SuperFabius/Z80-MBC/A041116 schematic.pdf

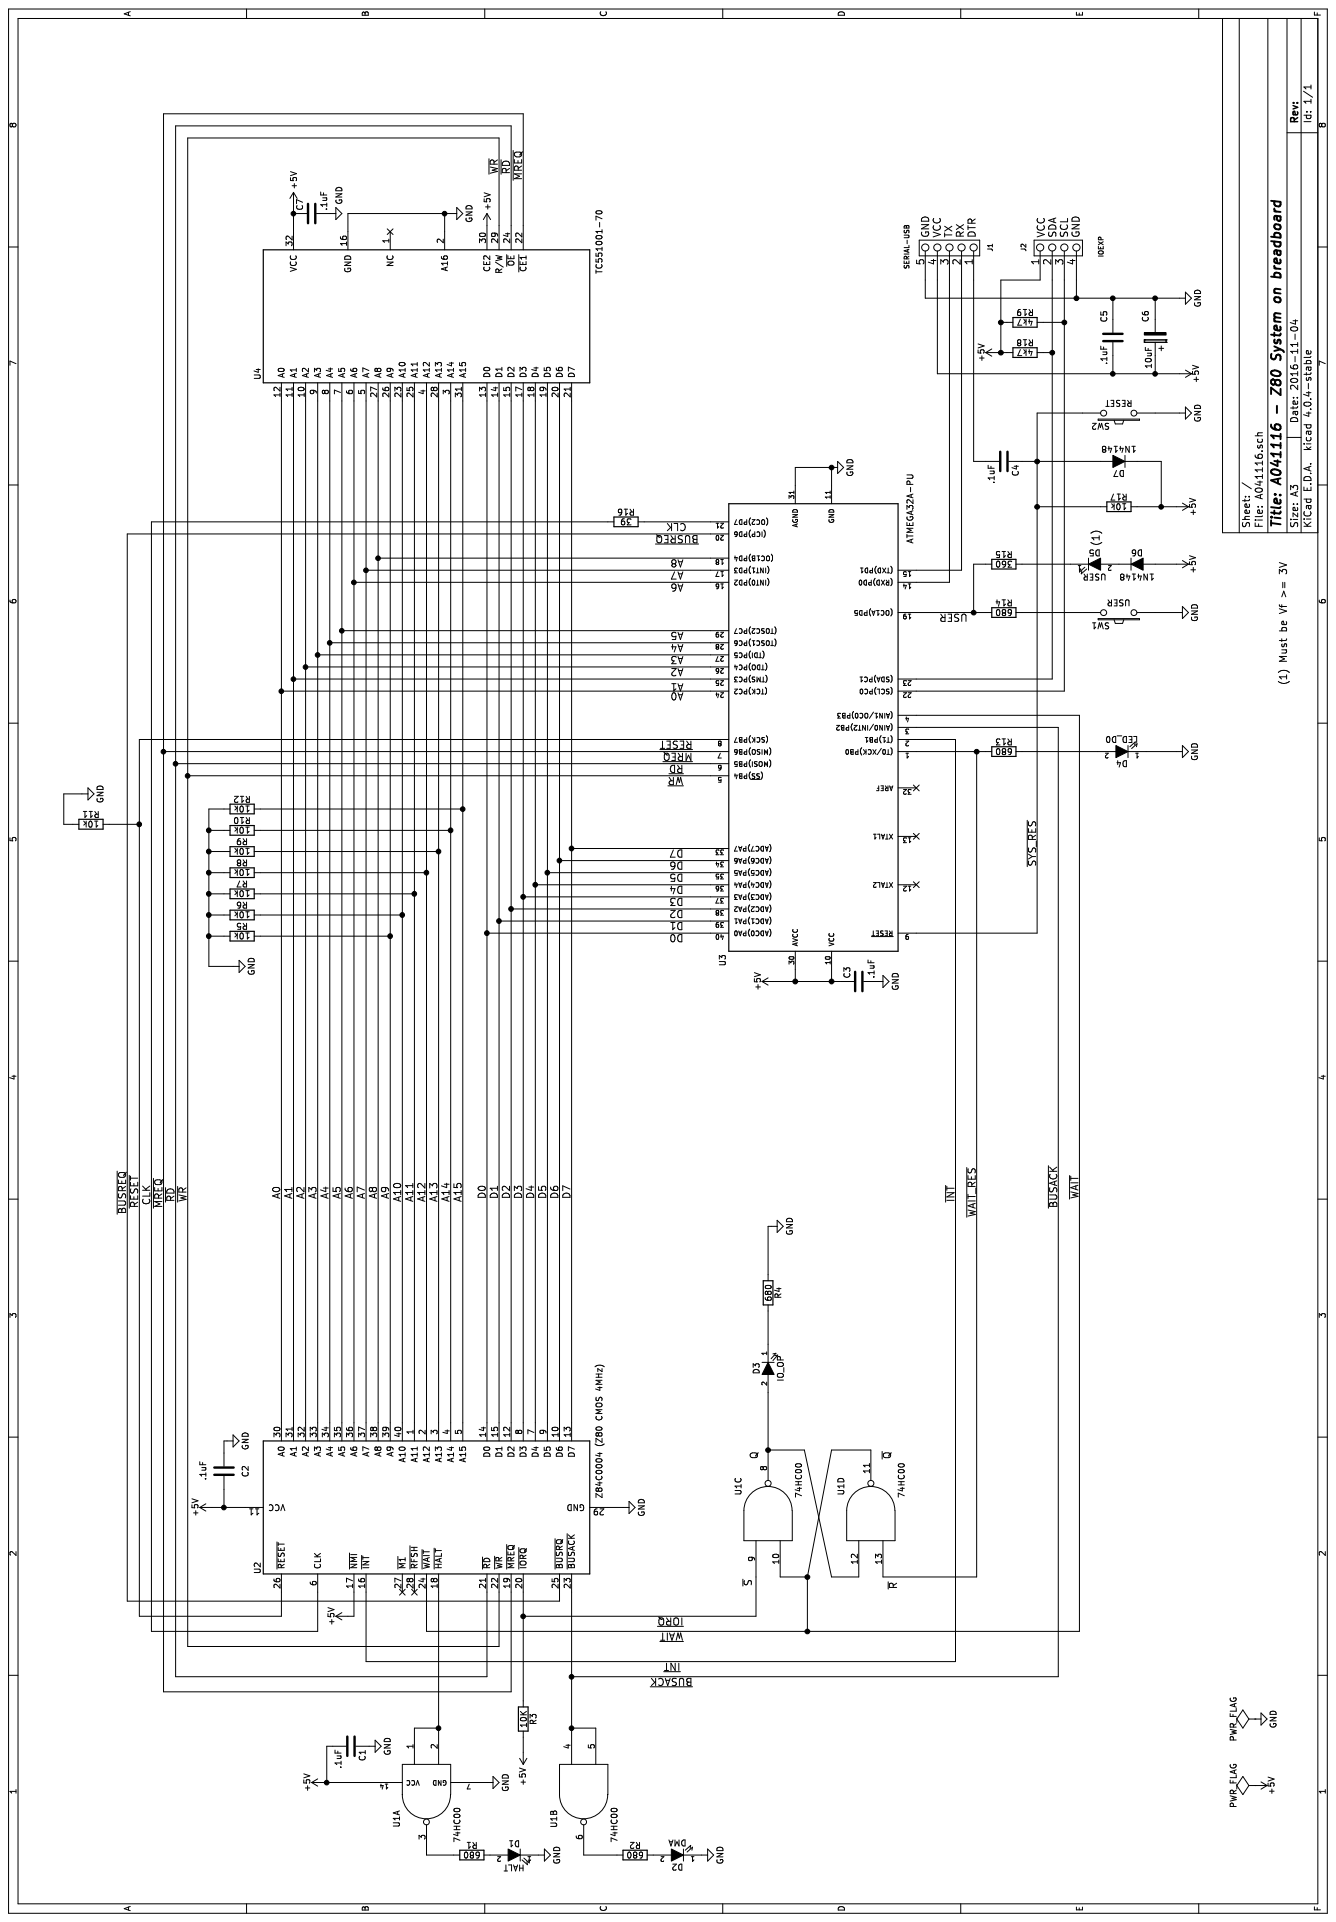
[picture p1: page 1]
