SuperFabius/Z80-MBC/A080117.pdf

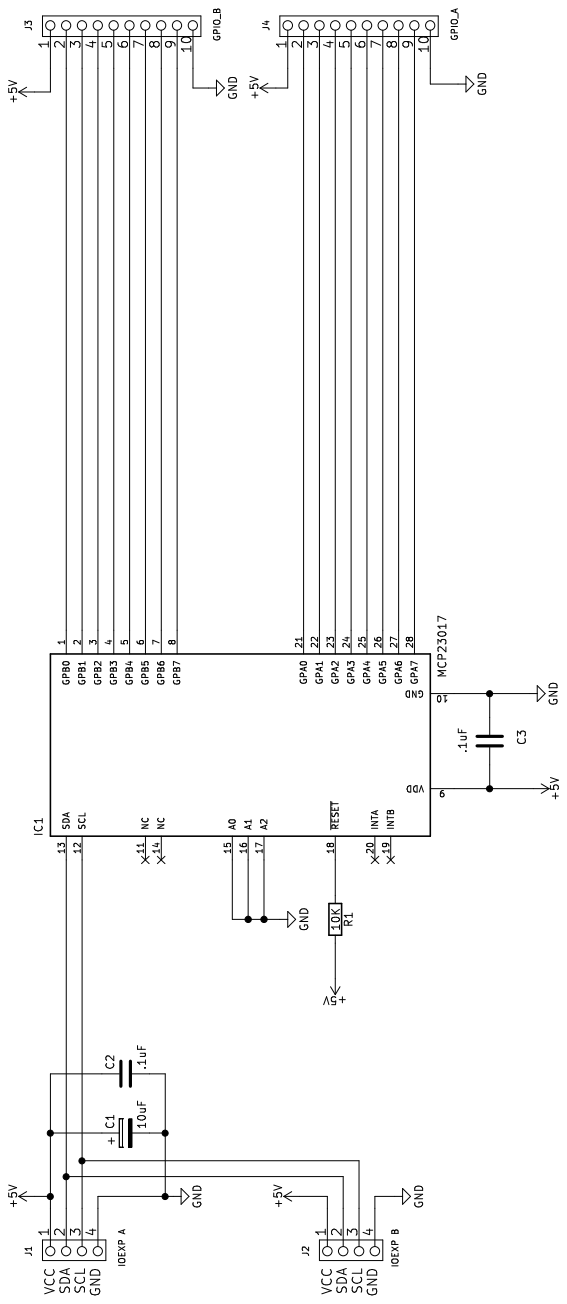
[picture p2: page 1]
