SuperFabius/Z80-MBC/A110417.pdf

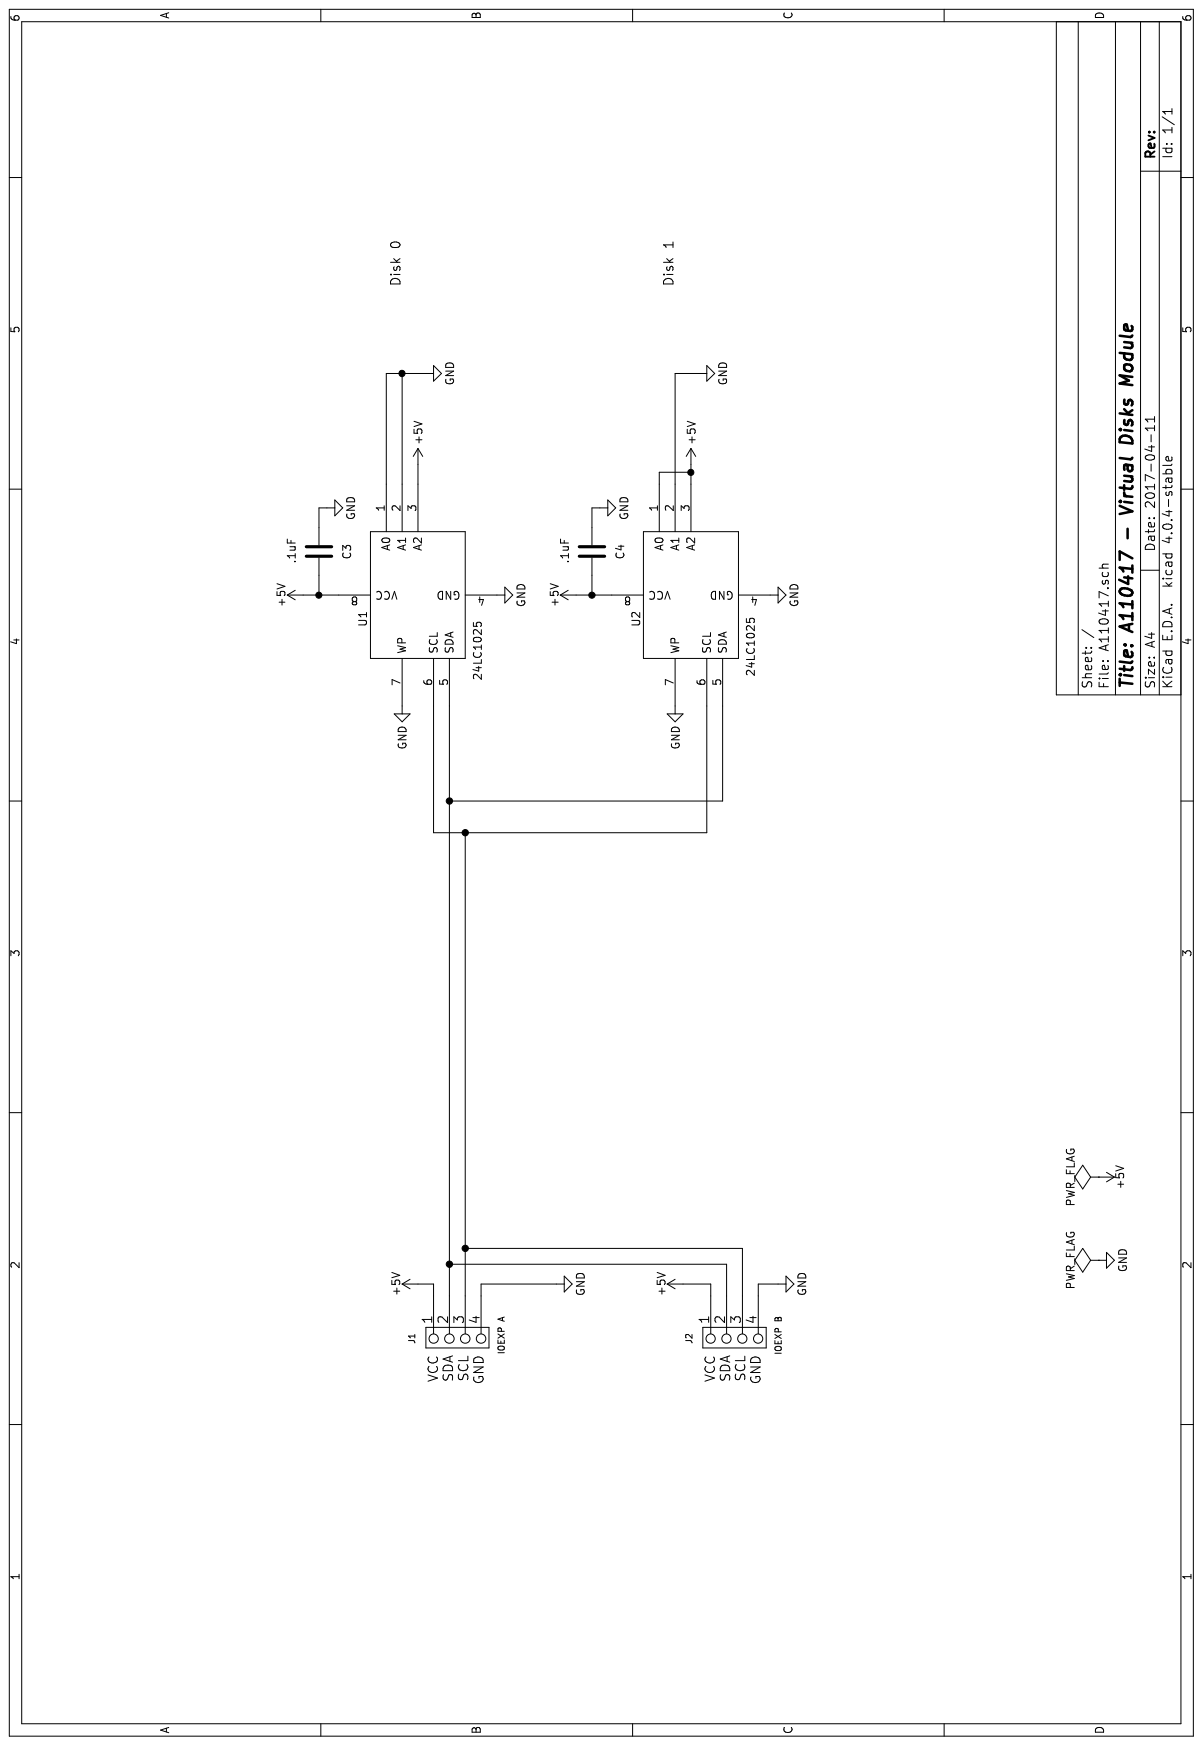
[picture p3: page 1]
