SuperFabius/Z80-MBC/S221116_R100218_Z80.ino

/* ------------------------------------------------------------------------------

S221116 R100218 - HW ref: A041116

IOS - I/O Subsystem - for Z80-MBC (Multi Boot Computer)
(Z80 64kB RAM @ 4Mhz)



Notes:

1:  This SW is ONLY for the Atmega32A used as EEPROM and I/O subsystem (8MHz internal oscillator).
    
2:  Tested on Atmega32A @ Arduino IDE 1.6.5.

3:  Embedded FW: S091216 R230117 uLoader, S121216 uBIOS + Basic, S260117 iLoad (Intel-Hex loader),
                 Forth interpreter, S150417 CP/M 2.2 Cold Loader

4:  Utilities:   S111216 TASM conversion utility

5:  Optional HW: A080117 (GPIO Expansion Module)
                 A110417 (Virtual Disk Module)
                 Generic DS3231 RTC

--------------------------------------------------------------------------------- */

/* ------------------------------------------------------------------------------

CHANGELOG:


S221116           First release.
S221116 R200117   Added support for the GPIO Extension Module (HW ref: A080117).
S221116 R230117   Added iLoad boot mode (S260117), updated uLoader (S091216 R230117).
S221116 R120217   Added Forth interpreter (porting made by Bill Westfield, see GitHub:
                  https://github.com/WestfW/4chipZ80/tree/master/Firmware/figForth )
                  and multi boot selection. Renamed from now as "Multi Boot Computer".
                  From this release the use of an Atmega32A is mandatory.
S221116 R180217   Added support for the Virtual Disk Module (HW ref: A110417).
S221116 R130417   Added CP/M Cold Loader (S150417) to support CP/M 2.2 and BIOS (S050217).
                  Single disk configuration now allowed (HW ref: A110417).
S221116 R300417   Added AUTOEXEC.SUB support for CP/M 2.2. Required new BIOS (S050217 R300417).
S221116 R110517   Added support for a generic DS3231 RTC for QP/M 2.71 timestamping.
                  Now supporting CP/ 2.2 and QP/M 2.71
S221116 R100218   Fixed the ghost RTC bug: when there isn't any Virtual Disk (only Basic and Forth)
                  the RTC clock was always incorrectly found. 

--------------------------------------------------------------------------------- */

// ------------------------------------------------------------------------------
//
// Hardware definitions for A041116 (Z80-MBC)
//
// ------------------------------------------------------------------------------

#define   D0          24  // PA0 pin 40   Z80 data bus
#define   D1          25  // PA1 pin 39
#define   D2          26  // PA2 pin 38
#define   D3          27  // PA3 pin 37
#define   D4          28  // PA4 pin 36
#define   D5          29  // PA5 pin 35
#define   D6          30  // PA6 pin 34
#define   D7          31  // PA7 pin 33

#define   AD0         18  // PC2 pin 24   Z80 address bus (AD0-AD8 = A0-A8 on A04113 schematic)
#define   AD1         19  // PC3 pin 25
#define   AD2         20  // PC4 pin 26
#define   AD3         21  // PC5 pin 27
#define   AD4         22  // PC6 pin 28
#define   AD5         23  // PC7 pin 29
#define   AD6         10  // PD2 pin 16
#define   AD7         11  // PD3 pin 17
#define   AD8         12  // PD4 pin 18

#define   INT_         1  // PB1 pin 2    Z80 control bus
#define   BUSACK_      2  // PB2 pin 3
#define   WAIT_        3  // PB3 pin 4
#define   WR_          4  // PB4 pin 5
#define   RD_          5  // PB5 pin 6
#define   MREQ_        6  // PB6 pin 7
#define   RESET_       7  // PB7 pin 8
#define   BUSREQ_     14  // PD6 pin 20
#define   CLK         15  // PD7 pin 21

#define   SCL_PC0     16  // PC0 pin 22   IOEXP connector
#define   SDA_PC1     17  // PC1 pin 23

#define   LED_D0       0  // PB0 pin 1    Led LED_0 ON if HIGH
#define   WAIT_RES_    0  // PB0 pin 1    Internal control line
#define   USER        13  // PD5 pin 19   Led USER and key

// ------------------------------------------------------------------------------
//
// Hardware definitions for A080117 (GPIO Expansion Module)
//
// ------------------------------------------------------------------------------

#define   GPIOEXP_ADDR  0x20  // I2C module address
#define   IODIRA_REG    0x00  // MCP23017 internal register IODIRA  (see datasheet)
#define   IODIRB_REG    0x01  // MCP23017 internal register IODIRB  (see datasheet)
#define   GPPUA_REG     0x0C  // MCP23017 internal register GPPUA  (see datasheet)
#define   GPPUB_REG     0x0D  // MCP23017 internal register GPPUB  (see datasheet)
#define   GPIOA_REG     0x12  // MCP23017 internal register GPIOA  (see datasheet)
#define   GPIOB_REG     0x13  // MCP23017 internal register GPIOB  (see datasheet)

// ------------------------------------------------------------------------------
//
// Hardware definitions for A110417 (Virtual Disk Module)
//
// ------------------------------------------------------------------------------

#define   EXT_EEPROM0   0x50  // I2C EEPROM 0 address (128kB)
#define   EXT_EEPROM1   0x51  // I2C EEPROM 1 address (128kB)

// ------------------------------------------------------------------------------
//
// Hardware definitions for a generic DS3231 RTC (see DS3231 datasheet)
//
// ------------------------------------------------------------------------------

#define   DS3231_RTC    0x68  // DS3231 I2C address
#define   DS3231_SECRG  0x00  // DS3231 Seconds Register
#define   DS3231_STATRG 0x0F  // DS3231 Status Register

// ------------------------------------------------------------------------------
//
//  Libraries
//
// ------------------------------------------------------------------------------

#include <avr/pgmspace.h>                 // Needed for PROGMEM
#include "Wire.h"                         // Needed for I2C bus
#include <EEPROM.h>                       // Needed for internal EEPROM R/W

// ------------------------------------------------------------------------------
//
//  Constants
//
// ------------------------------------------------------------------------------

const String  compTimeStr  = __TIME__;  // Compile timestamp string
const String  compDateStr  = __DATE__;  // Compile datestamp string
const byte    daysOfMonth[] = {31, 28, 31, 30, 31, 30, 31, 31, 30, 31, 30, 31};
const byte    debugLev1    = B00000001; // Debug level 1 mask
const byte    debugLev2    = B00000010; // Debug level 2 mask
const byte    debugLev3    = B00000100; // Debug level 3 mask
const byte    debugLev4    = B00001000; // Debug level 4 mask
const byte    debugLev     = 0;         // Set the level of debug (0 = no debug, debugLev1 = only phase 1 boot, 
                                        // debugLev2 = phase 2 boot + runtime I/O, debugLev3 = disk emulation short, 
                                        // debugLev4 = disk emulation verbose)
                                        // NOTE: multiple debug levels can be "or"-ed


const word  bootPhase1StrAddr = 0x0000; // Phase 1 payload image starting address
const byte  bootPhase1[] PROGMEM = {    // Phase 1 payload image (S091216 R230117 uLoader) 
  0x18, 0x04, 0x00, 0x00, 0x00, 0x00, 0x21, 0x14, 0x00, 0x11, 0x80, 0xFF, 0x01, 0x24, 0x00, 0xED, 
  0xB0, 0xC3, 0x80, 0xFF, 0xED, 0x5B, 0x04, 0x00, 0x2A, 0x02, 0x00, 0xDD, 0x2A, 0x02, 0x00, 0x0E, 
  0x02, 0x06, 0x00, 0x7A, 0xB7, 0xCA, 0x9A, 0xFF, 0xED, 0xB2, 0x3D, 0xC3, 0x91, 0xFF, 0x7B, 0xB7, 
  0xCA, 0xA2, 0xFF, 0x43, 0xED, 0xB2, 0xDD, 0xE9
  }; 

const word  bootPh2_A_StrAddr = 0x0000;// Phase 2 payload A image starting address
const byte  bootPh2_A_[] PROGMEM = {   // Phase 2 payload A image (S121216 uBIOS + Basic)
  0xF3, 0xC3, 0xA4, 0x00, 0x00, 0x00, 0x00, 0x00, 0xC3, 0x91, 0x00, 0x00, 0x00, 0x00, 0x00, 0x00, 
  0xC3, 0x6A, 0x00, 0x00, 0x00, 0x00, 0x00, 0x00, 0xC3, 0x96, 0x00, 0x00, 0x00, 0x00, 0x00, 0x00, 
  0x00, 0x00, 0x00, 0x00, 0x00, 0x00, 0x00, 0x00, 0x00, 0x00, 0x00, 0x00, 0x00, 0x00, 0x00, 0x00, 
  0x00, 0x00, 0x00, 0x00, 0x00, 0x00, 0x00, 0x00, 0x18, 0x00, 0xF5, 0xE5, 0xDB, 0x01, 0xF5, 0x3A, 
  0x43, 0x20, 0xFE, 0x3F, 0x20, 0x03, 0xF1, 0x18, 0x1C, 0x2A, 0x3F, 0x20, 0x23, 0x7D, 0xFE, 0x3F, 
  0x20, 0x03, 0x21, 0x00, 0x20, 0x22, 0x3F, 0x20, 0xF1, 0x77, 0x3A, 0x43, 0x20, 0x3C, 0x32, 0x43, 
  0x20, 0xFE, 0x30, 0x38, 0x00, 0xE1, 0xF1, 0xFB, 0xED, 0x4D, 0x3A, 0x43, 0x20, 0xFE, 0x00, 0x28, 
  0xF9, 0xE5, 0x2A, 0x41, 0x20, 0x23, 0x7D, 0xFE, 0x3F, 0x20, 0x03, 0x21, 0x00, 0x20, 0xF3, 0x22, 
  0x41, 0x20, 0x3A, 0x43, 0x20, 0x3D, 0x32, 0x43, 0x20, 0xFE, 0x05, 0x30, 0x00, 0x7E, 0xFB, 0xE1, 
  0xC9, 0xF5, 0xF1, 0xD3, 0x01, 0xC9, 0x3A, 0x43, 0x20, 0xFE, 0x00, 0xC9, 0x7E, 0xB7, 0xC8, 0xCF, 
  0x23, 0x18, 0xF9, 0xC9, 0x21, 0xED, 0x20, 0xF9, 0x21, 0x00, 0x20, 0x22, 0x3F, 0x20, 0x22, 0x41, 
  0x20, 0xAF, 0x32, 0x43, 0x20, 0xED, 0x56, 0xFB, 0x21, 0xF1, 0x00, 0xCD, 0x9C, 0x00, 0x3A, 0x44, 
  0x20, 0xFE, 0x59, 0x20, 0x16, 0x21, 0x2A, 0x01, 0xCD, 0x9C, 0x00, 0xCD, 0x6A, 0x00, 0xE6, 0xDF, 
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
  0x20, 0x43, 0x6F, 0x6C, 0x64, 0x20, 0x4C, 0x6F, 0x61, 0x64, 0x65, 0x72, 0x20, 0x2D, 0x20, 0x53, 
  0x31, 0x35, 0x30, 0x34, 0x31, 0x37, 0x0D, 0x0A, 0x4C, 0x6F, 0x61, 0x64, 0x69, 0x6E, 0x67, 0x2E, 
  0x2E, 0x2E, 0x00, 0x20, 0x64, 0x6F, 0x6E, 0x65, 0x0D, 0x0A, 0x00
  };

const byte * const bootPh2Table[4] PROGMEM = {bootPh2_A_, bootPh2_B_, bootPh2_C_, bootPh2_D_}; // Phase 2 payload addresses table
const byte  bootModeAddr  = 10;          // Internal EEPROM address for boot mode storage
const byte  diskLightAddr = 11;          // Internal EEPROM address for disck light flag storage
const byte  autoexecFlagAddr = 12;       // Internal EEPROM address for AUTOEXEC flag storage

// ------------------------------------------------------------------------------
//
//  Global variables
//
// ------------------------------------------------------------------------------

// General purpose variables
byte          ioAddress;
byte          ioData;
byte          tempByte;
word          indexPhase2    = 0;         // Index for the Phase 2 array
byte          moduleGPIO     = 0;         // Set to 1 if the module is found, 0 otherwise
byte          bootMode       = 0;         // Set the payload array to use for Phase 2 loading 
                                          // (0: bootPh2_A_[], 1: bootPh2_C_[], 2: bootPh2_B_[])
byte *        Ph2Image;                   // Pointer to selected payload array or Phase 2 boot
word          Ph2ImageSize;               // Size of the selected Phase 2 payload array
word          Ph2StrAddr;                 // Starting address of the selected Phase 2 boot
byte          Z80IntEnFlag   = 0;         // Z80 INT_ enable flag (0 = No INT_ used, 1 = INT_ used for I/O)
unsigned long timeStamp;                  // Timestamp for led blinking
char          inChar;                     // Input char from serial

// Disk emulation variables
byte          diskSel;                    // Selected Virtual Disk (binary)
word          trackSel;                   // Selected Track (binary)
word          sectSel;                    // Selected Sector (binary)
byte          trackByteCnt;               // Byte counter used for SELTRACK multi-byte I/O operation (from Z80 bus)
byte          sectByteCnt;                // Byte counter used for SELSECT multi-byte I/O operation (from Z80 bus)
byte          diskDataByteCnt = 255;      // Byte counter used for WRITESECT and READSECT multi-byte I/O operation (from Z80 bus)
word          EEpage;                     // I2C EEPROM page number (used for WRITESECT and READSECT)
byte          EEaddr;                     // I2C EEPROM address (used for WRITESECT and READSECT)
byte          blockSel;                   // Used for the I2C EEPROM 17th data address bit (A16)
byte          iCount;                     // Temporary variable
byte          diskI2CError;               // Error code during I2C EEPROM access
byte          vDisk = 0;                  // Set to 1 if Virtual Disk Module is found (2x 128kB)
byte          notFoundDisk1  = 1;         // Set to 0 if Disk1 is found, 1 if not found (single disk system)
unsigned long writeTime1, writeTime2;     // Timestamps for write operations (only for debug)
byte          diskLightFlag;              // Enable the disk activity led using USER led ( 0 = off, 1 = enabled)

// DS3231 RTC variables
byte          foundRTC;                   // Set to 1 if RTC is found, 0 otherwise
byte          RTCbyteCnt     = 0;         // Byte counter used for DATETIME multi-byte I/O operation (from Z80 bus)
byte          seconds, minutes, hours, day, month, year;

// CP/M support variables
byte          autoexecFlag;               // Set to 1 if AUTOEXEC must be executed at cold boot, 0 otherwise

// ------------------------------------------------------------------------------

void setup() {
  
// ------------------------------------------------------------------------------
//
//  Local variables
//
// ------------------------------------------------------------------------------

  byte          data;                       // External RAM data byte
  word          address;                    // External RAM current address;
  char          minBootChar  = '1';         // Minimum allowed ASCII value selection (boot selection)
  char          maxSelChar   = '3';         // Maximum allowed ASCII value selection (boot selection)
  byte          maxBootMode  = 2;           // Default maximum allowed value for bootMode [0..2]
  byte          bootSelection = 0;          // Flag to enter into the boot mode selection

// ------------------------------------------------------------------------------

  // Initialize RESET_ and WAIT_RES_
  pinMode(RESET_, OUTPUT);                        // Configure RESET_ and set it ACTIVE
  digitalWrite(RESET_, LOW);
  pinMode(WAIT_RES_, OUTPUT);                     // Configure WAIT_RES_ and set it ACTIVE to reset the WAIT FF (U1C)
  digitalWrite(WAIT_RES_, LOW);

  // Check USER Key for boot mode changes 
  pinMode(USER, INPUT_PULLUP);                    // Read USER Key to enter into the boot mode selection
  if (!digitalRead(USER)) bootSelection = 1;

  // Initialize USER,  INT_, BUSACK_, and BUSREQ_
  pinMode(USER, OUTPUT);                          // USER led OFF
  digitalWrite(USER, HIGH);
  pinMode(INT_, INPUT_PULLUP);                    // Configure INT_ and set it NOT ACTIVE
  pinMode(INT_, OUTPUT);
  digitalWrite(INT_, HIGH);
  pinMode(BUSACK_, INPUT);                        // Configure BUSACK_ as input
  pinMode(WAIT_, INPUT);                          // Configure WAIT_ as input
  pinMode(BUSREQ_, INPUT_PULLUP);                 // Set BUSREQ_ HIGH
  pinMode(BUSREQ_, OUTPUT);
  digitalWrite(BUSREQ_, HIGH);

  // Initialize D0-D7, AD0-AD8, MREQ_, RD_ and WR_
  DDRA = 0x00;                                    // Configure Z80 data bus D0-D7 (PA0-PA7) as input with pull-up
  PORTA = 0xFF;
  DDRC = DDRC & B00000011;                        // Configure Z80 address bus AD0-AD5 (PC2-PC7) as input with pull-up
  PORTC = PORTC | B11111100;
  DDRD = DDRD & B11100011;                        // Configure Z80 address bus AD6-AD8 (PD2-PD4) as input with pull-up
  PORTD = PORTD | B00011100;
  pinMode(MREQ_, INPUT_PULLUP);                   // Configure MREQ_ as input with pull-up
  pinMode(RD_, INPUT_PULLUP);                     // Configure RD_ as input with pull-up
  pinMode(WR_, INPUT_PULLUP);                     // Configure WR_ as input with pull-up
  
  // Initialize CLK @ 4MHz. Z80 clock_freq = (Atmega_clock) / (OCR2 + 1) = (Atmega_clock) / 2
  ASSR &= ~(1 << AS2);                            // Set Timer2 clock from system clock
  TCCR2 |= (1 << CS20);                           // Set Timer2 clock to "no prescaling"
  TCCR2 &= ~((1 << CS21) | (1 << CS22));
  TCCR2 |= (1 << WGM21);                          // Set Timer2 CTC mode
  TCCR2 &= ~(1 << WGM20);
  TCCR2 |= (1 <<  COM20);                         // Set "toggle OC2 on compare match"
  TCCR2 &= ~(1 << COM21);
  OCR2 = 0;                                       // Set the compare value to toggle OC2
  pinMode(CLK, OUTPUT);                           // Set OC2 as output and start to output the clock @ 4Mhz

  // Initialize the EXP_PORT (I2C) and search for "known" optional modules
  Wire.begin();                                   // Wake up I2C bus
  TWBR = 12;                                      // Set I2C speed at 200KHz (@ clock = 8MHz)
  Wire.beginTransmission(GPIOEXP_ADDR);
  if (Wire.endTransmission() == 0) moduleGPIO = 1;// Set to 1 if GPIO Module is found
  Wire.beginTransmission(EXT_EEPROM0);
  if (Wire.endTransmission() == 0)
  {
    vDisk = 1;                                    // Set to 1 if Virtual Disk Module is found
    Wire.beginTransmission(EXT_EEPROM1);
    if (Wire.endTransmission() == 0) notFoundDisk1 = 0; // Set to 0 if Disk1 is not found
  }
  
  // Print some system information
  Serial.begin(9600);
  Serial.println();
  Serial.println("Z80-MBC (Multi Boot Computer) - A041116");
  Serial.println("IOS - I/O Subsystem - S221116 R100218");
  Serial.println();
  foundRTC = autoSetRTC();                        // Check if RTC is present and initialize it as needed
  if (moduleGPIO) Serial.println("IOS: Found GPIO Expansion Module");
  if (vDisk)
  // Found Virtual Disk Module. Check Disk Light and AUTOEXEC flags
  {
    Serial.println("IOS: Found Virtual Disk Module");
    if (notFoundDisk1) Serial.println("IOS: Warning: Disk 1 not found");
    Serial.print("IOS: Disk light is ");
    if (EEPROM.read(diskLightAddr) > 1) EEPROM.write(diskLightAddr, 0);  // Reset disk light flag to OFF if invalid value
    diskLightFlag = EEPROM.read(diskLightAddr);   // Read the previous stored disk light flag
    if (diskLightFlag) Serial.println("ON");
    else Serial.println("OFF");
    Serial.print("IOS: AUTOEXEC execution is ");
    if (EEPROM.read(autoexecFlagAddr) > 1) EEPROM.write(autoexecFlagAddr, 0); // Reset AUTOEXEC flag to OFF if invalid value
    autoexecFlag = EEPROM.read(autoexecFlagAddr); // Read the previous stored AUTOEXEC flag
    if (autoexecFlag) Serial.println("ON");
    else Serial.println("OFF");
  }

  // Boot selection
  bootMode = EEPROM.read(bootModeAddr);           // Read the previous stored boot mode
  if (vDisk == 1) maxBootMode = 3;                // Allow CP/M selection if virtual disk module has been found
  if ((bootSelection == 1 ) || (bootMode > maxBootMode))
  // Enter in the boot selection menu if USER key was pressed at startup 
  // or an invalid bootMode code was read from internal EEPROM
  {
    while (Serial.available() > 0) 
    // Flush input buffer
    {
      Serial.read();
    }
    Serial.println();
    Serial.println("IOS: Select boot mode:");
    Serial.println();
    if (bootMode <= maxBootMode)
    // Previous valid boot mode read, so enable '0' selection
    {
      minBootChar = '0';
      Serial.print(" 0: No change (->");
      Serial.print(bootMode + 1);
      Serial.println(")");
    }
    Serial.println(" 1: Basic");
    Serial.println(" 2: Forth");
    Serial.println(" 3: iLoad");
    if (vDisk == 1)
    // Virtual disk module found, so enable disk light and OS load related selections
    {
      Serial.println(" 4: Load OS from Disk 0");
      Serial.print(" 5: Toggle disk light (->");
      if (diskLightFlag) Serial.print("ON");
      else Serial.print("OFF");
      Serial.println(")");
      Serial.print(" 6: Toggle AUTOEXEC execution (->");
      if (autoexecFlag) Serial.print("ON");
      else Serial.print("OFF");
      Serial.println(")");
      if (foundRTC)
      // Found RTC
      {
        Serial.println(" 7: Change RTC time/date");
        maxSelChar = '7';
      }
      else maxSelChar = '6';
    }
    Serial.println();
    timeStamp = millis();
    Serial.print("Enter your choice >");
    do
    {
      blinkD0(&timeStamp);
      inChar = Serial.read();
    }               
    while ((inChar < minBootChar) || (inChar > maxSelChar));
    Serial.println(inChar);
    if (inChar == '5')
    // Change disk light status
    {
      diskLightFlag = !diskLightFlag;             // Toggle disk light status
      EEPROM.write(diskLightAddr, diskLightFlag); // Save it to the internal EEPROM
    }
    if (inChar == '6')
    // Change AUTOEXEC execution status
    {
      autoexecFlag = !autoexecFlag;               // Toggle AUTOEXEC executiont status
      EEPROM.write(autoexecFlagAddr, autoexecFlag); // Save it to the internal EEPROM
    }
    if (inChar == '7') ChangeRTC();               // Change RTC Date/Time
    bootMode = inChar - '1';                      // Calculate bootMode from inChar
    if (bootMode < 4) EEPROM.write(bootModeAddr, bootMode); // Save to the internal EEPROM if required
    else bootMode = EEPROM.read(bootModeAddr);    // Reload boot mode if '0' or > '5' choice selected
  }

  // Get the address of the payload array in PROGMEM for the Phase 2 boot and its size
  switch (bootMode)
  {
    case 0:                                       // Basic boot
      Ph2Image = (byte *) pgm_read_word (&bootPh2Table[0]); 
      Ph2ImageSize = sizeof(bootPh2_A_);
      Ph2StrAddr = bootPh2_A_StrAddr;
      Z80IntEnFlag = 1;                           // Enable INT_ signal generation (Z80 M1 INT I/O)
    break;
    case 1:                                       // Forth boot
      Ph2Image = (byte *) pgm_read_word (&bootPh2Table[2]); 
      Ph2ImageSize = sizeof(bootPh2_C_);
      Ph2StrAddr = bootPh2_C_StrAddr;
    break;
    case 2:                                       // iLoad boot
      Ph2Image = (byte *) pgm_read_word (&bootPh2Table[1]); 
      Ph2ImageSize = sizeof(bootPh2_B_);
      Ph2StrAddr = bootPh2_B_StrAddr;
    break;
    case 3:                                       // CP/M Loader
      Ph2Image = (byte *) pgm_read_word (&bootPh2Table[3]); 
      Ph2ImageSize = sizeof(bootPh2_D_);
      Ph2StrAddr = bootPh2_D_StrAddr;
    break;
  }

  // Realease Z80 from reset and start DMA
  delay(1);                                       // Wait for reset completed (just to be sure)
  digitalWrite(WAIT_RES_, HIGH);                  // Set WAIT_RES_ HIGH (Led LED_0 ON)
  digitalWrite(BUSREQ_, LOW);                     // Activate DMA request signal
  delay(1);
  digitalWrite(RESET_, HIGH);                     // Release Z80 from RESET
  delay(1);                                       // Wait for Z80 bus thee-stated

  // Load Phase 1 boot payload into external RAM with DMA and using address (AD0-AD8) and data (D0-D7) bus
  address = bootPhase1StrAddr;                    // Initialize the starting address of external RAM 
  Serial.println("IOS: Loading phase 1 boot program...");
  pinMode(WR_, OUTPUT);                           // Configure WR_ as ouput and set it HIGH
  digitalWrite(WR_, HIGH);
  pinMode(RD_, OUTPUT);                           // Configure RD_ as ouput and set it HIGH
  digitalWrite(RD_, HIGH);
  pinMode(MREQ_, OUTPUT);                         // Configure MREQ_ as ouput and set it HIGH
  digitalWrite(MREQ_, HIGH);
  for (int i = 0; i < sizeof(bootPhase1); i++)
  // Write boot program into external RAM
  {
    if (debugLev & debugLev1)
    {
      Serial.print("DMA WRITE -> ADDR: ");
      Serial.print(address, HEX);
      Serial.print(" - DATA: ");
    }
    switch (i)
    // Get the current data to write into external RAM (Compliant with uLoader S091216 R230117)
    {
      case 2:
      // Send the LSB of the starting addres of the phase 2 boot program
        data = lowByte(Ph2StrAddr);
      break;
              
      case 3:
      // Send the MSB of the starting addres of the phase 2 boot program
        data = highByte(Ph2StrAddr);
      break;

      case 4:
      // Send the LSB of the lenght in bytes of the phase 2 boot program
        data = lowByte(Ph2ImageSize);
      break;

      case 5:
      // Send the MSB of the lenght in bytes of the phase 2 boot program
        data = highByte(Ph2ImageSize);
      break;

      default:
      // Get a byte of the phase 1 payload
        data = pgm_read_byte(&bootPhase1[i]);
      break;
    }

    if (debugLev & debugLev1)
    {
      if (data < 0x10) Serial.print("0");
      Serial.println(data, HEX);
      Serial.println("      76543210       76543210");
      Serial.print("PORTC=");
      printBinaryByte(PORTC);
      Serial.print(" PORTD=");
      printBinaryByte(PORTD);
      Serial.println();
    }

    // Confifgure D0-D7 and AD0-AD8 as output and write a byte into external RAM
    DDRA = 0xFF;                                  // Configure Z80 data bus D0-D7 (PA0-PA7) as output
    PORTA = data;                                 // Current output on data bus
    DDRC = DDRC | B11111100;                      // Configure Z80 address bus AD0-AD5 (PC2-PC7) as output
    DDRD = DDRD | B00011100;                      // Configure Z80 address bus AD6-AD8 (PD2-PD4) as output
    PORTC = (PORTC & B00000011) | ((lowByte(address) << 2) & B11111100);  // Output address AD0-AD5 (PC2-PC7)
    PORTD = (PORTD & B11100011) | (byte(address >> 4 ) & B00011100);      // Output address AD6-AD8 (PD2-PD4)
    digitalWrite(MREQ_, LOW);                     // Enable external RAM /CE1 pin
    digitalWrite(WR_, LOW);                       // Write data into current address of the external RAM (10us 1-0-1 pulse)
    digitalWrite(WR_, HIGH);
    address++;                                    // Set next address
  }
  Serial.println("IOS: Loading phase 1 done.");

  // Release Z80 address AD0-AD8 and data D0-D7 bus and run the Z80 CPU
  pinMode(WR_, INPUT_PULLUP);                     // Configure WR_ as input with pull-up
  pinMode(WR_, INPUT);
  pinMode(RD_, INPUT_PULLUP);                     // Configure RD_ as input with pull-up
  pinMode(RD_, INPUT);
  pinMode(MREQ_, INPUT_PULLUP);                   // Configure MREQ_ as input with pull-up
  DDRA = 0x00;                                    // Configure Z80 data bus D0-D7 (PA0-PA7) as input with pull-up
  PORTA = 0xFF;
  DDRC = DDRC & B00000011;                        // Configure Z80 address bus AD0-AD5 (PC2-PC7) as input with pull-up
  PORTC = PORTC | B11111100;
  DDRD = DDRD & B11100011;                        // Configure Z80 address bus AD6-AD8 (PD2-PD4) as input with pull-up
  PORTD = PORTD | B00011100;
  digitalWrite(RESET_, LOW);                      // Activate Z80 RESET_ signal
  digitalWrite(BUSREQ_, HIGH);                    // Release Z80 from DMA
  digitalWrite(RESET_, HIGH);                     // Release Z80 from RESET. Z80 is running from now
  Serial.println("IOS: Z80 is running from now.");
  Serial.println();
}

// ------------------------------------------------------------------------------

void loop() {
  if (!digitalRead(WAIT_))
  // IO operaton requested
  {
    if (!digitalRead(WR_))
    // IO WRITE operation requested
    {
      ioAddress = PINC >> 2;                      // Read Z80 address bus AD0-AD5 (PC2-PC7)
      ioAddress = (ioAddress & B00111111) | ((PIND << 4) & B11000000);  // Read Z80 address bus AD6-AD7 (PD2-PD3)
      ioData = PINA;                              // Read Z80 data bus D0-D7 (PA0-PA7)

      if (debugLev & debugLev2)
      {
        Serial.print("IOS: I/O WRITE operation requested");
        Serial.print(" - DATA: ");
        if (ioData < 0x10) Serial.print("0");
        Serial.print(ioData, HEX);
        Serial.print(" ");
        printBinaryByte(ioData);
        Serial.print(" ADDR: ");
        if (ioAddress < 0x10) Serial.print("0");
        Serial.print(ioAddress, HEX);
        Serial.print(" ");
        printBinaryByte(ioAddress);
        Serial.println();
      }
      switch (ioAddress)
      // Execute the requested I/O WRITE operation
      {
        case  0x00:
          // USER LED:      
          //                I/O DATA:    D7 D6 D5 D4 D3 D2 D1 D0
          //                            ---------------------------------------------------------
          //                              x  x  x  x  x  x  x  0    USER Led off
          //                              x  x  x  x  x  x  x  1    USER Led on
          
          if (ioData & B00000001) digitalWrite(USER, LOW); 
          else digitalWrite(USER, HIGH);
        break;
        
        case  0x01:
          // SERIAL TX:     
          //                I/O DATA:    D7 D6 D5 D4 D3 D2 D1 D0
          //                            ---------------------------------------------------------
          //                             D7 D6 D5 D4 D3 D2 D1 D0    ASCII char to be sent to serial
          
          Serial.write(ioData);
        break;
        
        case  0x03:
          // GPIOA write (GPIO Expansion Module):
          //
          //                I/O DATA:    D7 D6 D5 D4 D3 D2 D1 D0
          //                            ---------------------------------------------------------
          //                             D7 D6 D5 D4 D3 D2 D1 D0    GPIOA value (see MCP32017 datasheet)
          
          if (moduleGPIO) 
          {
            Wire.beginTransmission(GPIOEXP_ADDR);
            Wire.write(GPIOA_REG);                // Select GPIOA
            Wire.write(ioData);                   // Write value
            Wire.endTransmission();
          }
        break;
        
        case  0x04:
          // GPIOB write (GPIO Expansion Module): 
          //   
          //                I/O DATA:    D7 D6 D5 D4 D3 D2 D1 D0
          //                            ---------------------------------------------------------
          //                             D7 D6 D5 D4 D3 D2 D1 D0    GPIOB value (see MCP32017 datasheet)
          
          if (moduleGPIO) 
          {
            Wire.beginTransmission(GPIOEXP_ADDR);
            Wire.write(GPIOB_REG);                // Select GPIOB
            Wire.write(ioData);                   // Write value
            Wire.endTransmission();
          }
        break;
        
        case  0x05:
          // IODIRA write (GPIO Expansion Module):
          //
          //                I/O DATA:    D7 D6 D5 D4 D3 D2 D1 D0
          //                            ---------------------------------------------------------
          //                             D7 D6 D5 D4 D3 D2 D1 D0    IODIRA value (see MCP32017 datasheet)
          
          if (moduleGPIO) 
          {
            Wire.beginTransmission(GPIOEXP_ADDR);
            Wire.write(IODIRA_REG);               // Select IODIRA
            Wire.write(ioData);                   // Write value
            Wire.endTransmission();
          }
        break;
        
        case  0x06:
          // IODIRB write (GPIO Expansion Module):
          //
          //                I/O DATA:    D7 D6 D5 D4 D3 D2 D1 D0
          //                            ---------------------------------------------------------
          //                             D7 D6 D5 D4 D3 D2 D1 D0    IODIRB value (see MCP32017 datasheet)
          
          if (moduleGPIO) 
          {
            Wire.beginTransmission(GPIOEXP_ADDR);
            Wire.write(IODIRB_REG);               // Select IODIRB
            Wire.write(ioData);                   // Write value
            Wire.endTransmission();
          }
        break;
        
        case  0x07:
          // GPPUA write (GPIO Expansion Module):
          //
          //                I/O DATA:    D7 D6 D5 D4 D3 D2 D1 D0
          //                            ---------------------------------------------------------
          //                             D7 D6 D5 D4 D3 D2 D1 D0    GPPUA value (see MCP32017 datasheet)
          
          if (moduleGPIO) 
          {
            Wire.beginTransmission(GPIOEXP_ADDR);
            Wire.write(GPPUA_REG);                // Select GPPUA
            Wire.write(ioData);                   // Write value
            Wire.endTransmission();
          }
        break;
        
        case  0x08:
          // GPPUB write (GPIO Exp. Mod. ):
          //
          //                I/O DATA:    D7 D6 D5 D4 D3 D2 D1 D0
          //                            ---------------------------------------------------------
          //                             D7 D6 D5 D4 D3 D2 D1 D0    GPPUB value (see MCP32017 datasheet)
          
          if (moduleGPIO) 
          {
            Wire.beginTransmission(GPIOEXP_ADDR);
            Wire.write(GPPUB_REG);                // Select GPPUB
            Wire.write(ioData);                   // Write value
            Wire.endTransmission();
          }
        break;

        case  0x09:
          // DISK EMULATION
          // SELDISK - select the disk number:
          //
          //                I/O DATA:    D7 D6 D5 D4 D3 D2 D1 D0
          //                            ---------------------------------------------------------
          //                             D7 D6 D5 D4 D3 D2 D1 D0    DISK number (binary)
          //
          // NOTE 1: Only 2 disk are allowed (disk 0 and disk 1).
          // NOTE 2: This function resets the byte counter used for all the multi-byte disk operations (SELTRACK, SELSECT,
          //         WRITESECT, READSECT).
          // NOTE 3: Because WRITESECT and READSECT do not reset their own byte counter, the SELDISK (with a correct disk number)
          //         must be used each time before using WRITESECT or READSECT. This is a "security" feature to limit the effect
          //         of "spurious" access to WRITESECT or READSECT from out of control programs.
          // NOTE 4: This function clears the I2C error code.
  
          diskSel = ioData;                       // Store the selected disk number
          trackByteCnt = 0;                       // Reset the byte counter used for SELTRACK multi-byte I/O (from Z80 bus)
          sectByteCnt = 0;                        // Reset the byte counter used for SELSECT multi-byte I/O (from Z80 bus)
          if (diskSel < 2)
          // Allowed disk number selected
          {
            diskDataByteCnt = 0;                  // Reset the byte counter used for WRITESECT and READSECT multi-byte I/O (from Z80 bus)
            diskI2CError = 0;                     // Clear I2C error code
          }
          if (debugLev & debugLev3)
          // Debug print
          {
            Serial.print("\nIOS: SELDISK --> diskSel= ");
            Serial.println(diskSel, HEX);
          }
        break;

        case  0x0A:
          // DISK EMULATION
          // SELTRACK - select the track number (word splitted in 2 bytes in sequence: DATA 0 and DATA 1):
          //
          //                I/O DATA 0:  D7 D6 D5 D4 D3 D2 D1 D0
          //                            ---------------------------------------------------------
          //                             D7 D6 D5 D4 D3 D2 D1 D0    Track number LSB
          //
          //                I/O DATA 1:  D7 D6 D5 D4 D3 D2 D1 D0
          //                            ---------------------------------------------------------
          //                             D7 D6 D5 D4 D3 D2 D1 D0    Track number MSB
          //
          // NOTE 1: Allowed track numbers are in the range [0..31]

          if (trackByteCnt == 0)
          {
            trackSel = ioData;                                              // LSB
            trackByteCnt++;                                                 // Increment counter for next I/O
          }
          else
          {
            trackSel = (((word) ioData) << 8) | lowByte(trackSel);          // MSB
            trackByteCnt = 0;                                               // Reset multi-byte I/O counter
          }

          if (debugLev & debugLev3)
          {
            Serial.print("\nIOS: SELTRACK --> trackSel = ");
            Serial.println(trackSel, HEX);
          }

        break;

        case  0x0B:
          // DISK EMULATION
          // SELSECT - select the sector number (word splitted in 2 bytes in sequence: DATA 0 and DATA 1):
          //
          //                I/O DATA 0:  D7 D6 D5 D4 D3 D2 D1 D0
          //                            ---------------------------------------------------------
          //                             D7 D6 D5 D4 D3 D2 D1 D0    Sector number LSB
          //
          //                I/O DATA 1:  D7 D6 D5 D4 D3 D2 D1 D0
          //                            ---------------------------------------------------------
          //                             D7 D6 D5 D4 D3 D2 D1 D0    Sector number MSB
          //
          // NOTE 1: Allowed sector numbers are in the range [1..32]

          if (sectByteCnt == 0)
          {
            sectSel = ioData;                                              // LSB
            sectByteCnt++;                                                 // Increment counter for next I/O
          }
          else
          {
            sectSel = (((word) ioData) << 8) |  lowByte(sectSel);          // MSB
            sectByteCnt = 0;                                               // Reset multi-byte I/O counter
          }

          if (debugLev & debugLev3)
          {
            Serial.print("\nIOS: SELSECT --> sectSel = ");
            Serial.println(sectSel, HEX);
          }

        break;

        case  0x0C:
          // DISK EMULATION
          // WRITESECT - write 128 subsequent data bytes on the current disk/track/sector:
          //
          //                 I/O DATA 0: D7 D6 D5 D4 D3 D2 D1 D0
          //                            ---------------------------------------------------------
          //                             D7 D6 D5 D4 D3 D2 D1 D0    First Data byte
          //
          //                      |               |
          //                      |               |
          //                      |               |                 <126 Data Bytes>
          //                      |               |
          //
          //               I/O DATA 127: D7 D6 D5 D4 D3 D2 D1 D0
          //                            ---------------------------------------------------------
          //                             D7 D6 D5 D4 D3 D2 D1 D0    128th Data byte (Last byte)
          //
          // NOTE 1: CP/M sectors (128 bytes) allocation is 1:1 with I2C EEPROM pages dimention (128 bytes). The I2C EEPROM pages
          //         (1024 total pages = 128kB) are divided into 32 "virtual" tracks of 32 "virtual" sectors each (128
          //         bytes each). Allowed track numbers are in the range [0..31] and allowed sector numbers
          //         are in the range [1..32]
          // NOTE 2: The "page write" mode is used to write into the I2C EEPROM. Due to the 32 bytes limit of the wire library,
          //         one 128 bytes sector is divided into eight 16 bytes "data packets". Each data packet is 
          //         written sequentially into the I2C EEPROM using the "page write" mode. Before each data packet
          //         2 bytes are inserted into the I2C write buffer with the address used for the "page write".
          
          if ((diskSel < 2) & (trackSel < 32) & ((sectSel - 1) < 32))
          // No disk, track, sector selection error
          {
            if (diskDataByteCnt < 128)
            {
              if (diskDataByteCnt == 0)
              // Calculate I2C EEPROM address
              {
                EEpage = (sectSel -1) + (32 * trackSel);              // Sector/track to I2C EEPROM page [0..1023] conversion
                blockSel = EEpage >> 9;                               // Set the I2C EEPROM 17th data address bit (A16)
                blockSel = blockSel << 2;                             // A16 -> bit2 (0 0 0 0 0 A16 0 0)
                if (!diskSel) EEaddr = EXT_EEPROM0 | blockSel;        // Select the I2C EEPROM to use
                else EEaddr = EXT_EEPROM1 | blockSel;
                if (debugLev & debugLev3)
                // Debug print
                {
                  Serial.println("\nIOS: WRITESECT");
                }
              }
              if ((diskDataByteCnt % 16) == 0)
              // Send I2C write address before first data byte (16 bytes data packet)
              {
                if (diskLightFlag) digitalWrite(USER, LOW);           // Disk light on
                Wire.beginTransmission(EEaddr);                       // Select the EEPROM (plus the 17th address bit A16)
                Wire.write(highByte(EEpage << 7));                    // Send the data address (16 bit A15-A0)
                Wire.write(lowByte((EEpage << 7) + diskDataByteCnt));
              }
              Wire.write(ioData);                                     // One data byte into the buffer
              if (debugLev & debugLev4)
              // Debug print
              {
                Serial.print("IOS: WRITESECT --> EEPROM ADDR: ");
                Serial.print(EEaddr, HEX);
                Serial.print(" - EEpage: ");
                Serial.print(EEpage, HEX);
                Serial.print(" - diskDataByteCnt: ");
                Serial.println(diskDataByteCnt, HEX);
                Serial.print(" - ioData: ");
                Serial.println(ioData, HEX);
              }

              if (((diskDataByteCnt + 1) % 16) == 0)
              // Write I2C buffer into the EEPROM
              {
                Wire.endTransmission();
                writeTime1 = millis();
                if (diskLightFlag) digitalWrite(USER, HIGH);           // Disk light off
                // Wait for write to finish (give up after 100 attempts)
                for (iCount = 0; iCount < 100; iCount++)
                {
                  delayMicroseconds(350);                              // Wait a while
                  Wire.beginTransmission(EEaddr);
                  Wire.write(highByte(EEpage << 7));
                  Wire.write(lowByte(EEpage << 7));
                  diskI2CError = Wire.endTransmission();
                  if (diskI2CError == 0)
                  break;
                }
                if (debugLev & debugLev3)
                // Debug print
                {
                  writeTime2 = millis();
                  Serial.print("IOS: WRITESECT --> diskI2CError: ");
                  Serial.print(diskI2CError);
                  Serial.print(" - write time: ");
                  Serial.print(writeTime2 - writeTime1);
                  Serial.println(" ms");
                }
              }
              diskDataByteCnt++;
            }
            else diskI2CError = 8;                                   // Write error (I/O byte counter overrun)
        }
        break;
      }

      // Control bus sequence to exit from a wait state (M I/O write cycle)
      digitalWrite(BUSREQ_, LOW);                 // Request for a DMA
      digitalWrite(WAIT_RES_, LOW);               // Reset WAIT FF exiting from WAIT state
      digitalWrite(WAIT_RES_, HIGH);              // Now Z80 is in DMA, so it's safe set WAIT_RES_ HIGH again
      digitalWrite(BUSREQ_, HIGH);                // Resume Z80 from DMA
    }
    else 
      if (!digitalRead(RD_))
      // IO READ operation requested
      {
        ioAddress = PINC >> 2;                    // Read Z80 address bus AD0-AD5 (PC2-PC7)
        ioAddress = (ioAddress & B00111111) | ((PIND << 4) & B11000000); // Read Z80 address bus AD6-AD7 (PD2-PD3)
        ioData = 0;                               // Clear input data buffer
        switch (ioAddress)
        // Execute the requested I/O READ operation
        {
          case  0x00:
            // USER KEY:      
            //                I/O DATA:    D7 D6 D5 D4 D3 D2 D1 D0
            //                            ---------------------------------------------------------
            //                              0  0  0  0  0  0  0  0    USER Key not pressed
            //                              0  0  0  0  0  0  0  1    USER Key pressed
            
            tempByte = digitalRead(USER);         // Save USER led status
            pinMode(USER, INPUT_PULLUP);          // Read USER Key
            ioData = !digitalRead(USER);
            pinMode(USER, OUTPUT); 
            digitalWrite(USER, tempByte);         // Restore USER led status
          break;

          case  0x01:
            // SERIAL RX:     
            //                I/O DATA:    D7 D6 D5 D4 D3 D2 D1 D0
            //                            ---------------------------------------------------------
            //                             D7 D6 D5 D4 D3 D2 D1 D0    ASCII char read from serial
            //
            // NOTE 1: if there is no input char, a value 0xFF is forced as input char.
            // NOTE 2: the INT_ signal is always reset (set to HIGH) after this I/O operation.
            
            ioData = 0xFF;
            if (Serial.available() > 0) ioData = Serial.read();
            digitalWrite(INT_, HIGH);
          break;

          case  0x02:
            // READ BOOT PHASE 2 PAYLOAD:
            //
            //                I/O DATA:    D7 D6 D5 D4 D3 D2 D1 D0
            //                            ---------------------------------------------------------
            //                             D7 D6 D5 D4 D3 D2 D1 D0    current byte of Phase 2 payload array
            //
            // NOTE 1: a new byte is read every I/O read operation, and the pointer is automatically incremented to next byte
            //         every I/O read operation.
            // NOTE 2: a value 0x00 is forced for successive readings if the end of Phase 2 payload array is reached.
            
            if (indexPhase2 < Ph2ImageSize) ioData = pgm_read_byte(Ph2Image + indexPhase2);
            indexPhase2++;
          break;

          case  0x03:
            // GPIOA read (GPIO Expansion Module):
            //
            //                I/O DATA:    D7 D6 D5 D4 D3 D2 D1 D0
            //                            ---------------------------------------------------------
            //                             D7 D6 D5 D4 D3 D2 D1 D0    GPIOA value (see MCP32017 datasheet)
            //
            // NOTE: a value 0x00 is forced if the GPIO Expansion Module is not present
            
            if (moduleGPIO) 
            {
              // Set MCP23017 pointer to GPIOA
              Wire.beginTransmission(GPIOEXP_ADDR);
              Wire.write(GPIOA_REG);
              Wire.endTransmission();
              // Read GPIOA
              Wire.beginTransmission(GPIOEXP_ADDR);
              Wire.requestFrom(GPIOEXP_ADDR, 1);
              ioData = Wire.read();
            }
          break;

          case  0x04:
            // GPIOB read (GPIO Expansion Module):
            //
            //                I/O DATA:    D7 D6 D5 D4 D3 D2 D1 D0
            //                            ---------------------------------------------------------
            //                             D7 D6 D5 D4 D3 D2 D1 D0    GPIOB value (see MCP32017 datasheet)
            //
            // NOTE: a value 0x00 is forced if the GPIO Expansion Module is not present
            
            if (moduleGPIO) 
            {
              // Set MCP23017 pointer to GPIOB
              Wire.beginTransmission(GPIOEXP_ADDR);
              Wire.write(GPIOB_REG);
              Wire.endTransmission();
              // Read GPIOB
              Wire.beginTransmission(GPIOEXP_ADDR);
              Wire.requestFrom(GPIOEXP_ADDR, 1);
              ioData = Wire.read();
            }
          break;

          case  0x05:
            // DISK EMULATION
            // ERRDISK - read disk error code (byte):
            //
            //                I/O DATA:    D7 D6 D5 D4 D3 D2 D1 D0
            //                            ---------------------------------------------------------
            //                             D7 D6 D5 D4 D3 D2 D1 D0    DISK error code (binary)
            //
            //                DISK error code:    0: no errors
            //                                    1: data too long to fit in transmit buffer (I2C)
            //                                    2: received NACK on transmit of address (I2C)
            //                                    3: received NACK on transmit of data (I2C)
            //                                    4: other error (I2C)
            //                                    8: WRITESECT error (I/O byte counter overrun)
            //                                    9: READSECT error (I/O byte counter overrun)
            //                                   10: data read error (I2C)
            //                                   11: invalid disk number
            //                                   12: invalid track number
            //                                   13: invalid sector number
            //                                   14: virtual disk module not found
            //

            if (vDisk < 1) ioData = 14;                           // 14: Virtual disk module not found
            else
              if (diskSel > 1) ioData = 11;                       // 11: Invalid disk number
              else
                if (trackSel > 32) ioData = 12;                   // 12: Invalid track number
                else
                  if ((sectSel - 1) > 31) ioData = 13;            // 13: Invalid sector number
                  else ioData = diskI2CError;                     // I2C EEPROM errors:
                                                                  //    0: no errors
                                                                  //    1: data too long to fit in transmit buffer 
                                                                  //    2: received NACK on transmit of address
                                                                  //    3: received NACK on transmit of data
                                                                  //    4: other error
                                                                  //    8: WRITESECT error (I/O byte counter overrun)
                                                                  //    9: READSECT error (I/O byte counter overrun)
                                                                  //   10: data read error

            if (debugLev & debugLev3)
            {
              Serial.print("\nIOS: ERRDISK --> errDisk = ");
              Serial.println(ioData, HEX);      
            }
          break;

          case  0x06:
            // DISK EMULATION
            // READSECT - read 128 subsequent data bytes from the current sector:
            //
            //                 I/O DATA:   D7 D6 D5 D4 D3 D2 D1 D0
            //                            ---------------------------------------------------------
            //                 I/O DATA 0  D7 D6 D5 D4 D3 D2 D1 D0    First Data byte
            //
            //                      |               |
            //                      |               |
            //                      |               |                 <126 Data Bytes>
            //                      |               |
            //
            //               I/O DATA 127  D7 D6 D5 D4 D3 D2 D1 D0
            //                            ---------------------------------------------------------
            //                             D7 D6 D5 D4 D3 D2 D1 D0    128th Data byte (Last byte)
            //
            // NOTE 1: CP/M sectors (128 bytes) allocation is 1:1 with I2C EEPROM pages dimention (128 bytes). The I2C EEPROM pages
            //         (1024 total pages = 128kB) are divided into 32 "virtual" tracks of 32 "virtual" sectors each (128
            //         bytes each). Allowed track numbers are in the range [0..31] and allowed sector numbers
            //         are in the range [1..32]
            // NOTE 2: The "byte read" mode is used to read from the I2C EEPROM. 
          
            if ((diskSel < 2) & (trackSel < 32) & ((sectSel - 1) < 32))
            // No disk, track, sector selection error
            {
              if (diskDataByteCnt == 0)
              // Send 2 bytes address (16 bit) to I2C EEPROM for the first byte to read
              {
                if (diskLightFlag) digitalWrite(USER, LOW);           // Disk light on
                EEpage = (sectSel -1) + (32 * trackSel);              // Sector/track to I2C EEPROM page [0..1023] conversion
                blockSel = EEpage >> 9;                               // Set the I2C EEPROM 17th data address bit (A16)
                blockSel = blockSel << 2;                             // A16 -> bit2 (0 0 0 0 0 A16 0 0)
                if (!diskSel) EEaddr = EXT_EEPROM0 | blockSel;        // Select the I2C EEPROM to use
                else EEaddr = EXT_EEPROM1 | blockSel;
                Wire.beginTransmission(EEaddr);                       // Send the address (17 bit) of the first byte to read 
                Wire.write(highByte(EEpage << 7));
                Wire.write(lowByte(EEpage << 7));
                Wire.endTransmission();
                if (debugLev & debugLev3)
                // Debug print
                {
                  Serial.print("\nIOS: READSECT --> EEaddr=");
                  Serial.print(EEaddr, HEX);
                  Serial.print(" - EEpage=");
                  Serial.print(EEpage, HEX);
                  Serial.print(" - blockSel=");
                  Serial.print(blockSel, BIN);
                  Serial.print(" - addrHigh=");
                  Serial.print(highByte(EEpage << 7), HEX);
                  Serial.print(" - addrLow=");
                  Serial.println(lowByte(EEpage << 7), HEX);
                }
                
              }
              if (diskDataByteCnt < 128)
              {
                if (Wire.requestFrom(EEaddr, (byte)1) == 0) diskI2CError = 10;          // I2C data read error
                else ioData = Wire.read();
                diskDataByteCnt++;
              }
              else diskI2CError = 9; // Read error: I/O byte counter overrun
              if (diskDataByteCnt == 127) if (diskLightFlag) digitalWrite(USER, HIGH);  // Disk light off
            }
            if (debugLev & debugLev4)
            {
              Serial.print("IOS: READSECT --> diskDataByteCnt=");
              if (diskDataByteCnt > 0) Serial.print(diskDataByteCnt-1, HEX);
              else Serial.print("0");
              Serial.print(" - ioData=");
              Serial.println(ioData, HEX);
            }
          break;

          case  0x07:
            // SYSFLAGS (Various system flags for the OS):      
            //                I/O DATA:    D7 D6 D5 D4 D3 D2 D1 D0
            //                            ---------------------------------------------------------
            //                              X  X  X  X  X  X  X  0    AUTOEXEC not enabled
            //                              X  X  X  X  X  X  X  1    AUTOEXEC enabled
            //                              X  X  X  X  X  X  0  X    DS3231 RTC not found
            //                              X  X  X  X  X  X  1  X    DS3231 RTC found
            //
            // NOTE: Currently only D0 and D1 are used

            ioData = autoexecFlag | (foundRTC << 1);
            RTCbyteCnt = 0;                        // Reset DATETIME he I/O byte counter to "seconds"
          break;

          case  0x08:
            // DATETIME (Read date/time from the RTC. Binary values):      
            //                I/O DATA:    D7 D6 D5 D4 D3 D2 D1 D0
            //                            ---------------------------------------------------------
            //                I/O DATA 0   D7 D6 D5 D4 D3 D2 D1 D0    seconds [0..59] (1st data byte)
            //                I/O DATA 1   D7 D6 D5 D4 D3 D2 D1 D0    minutes [0..59]
            //                I/O DATA 2   D7 D6 D5 D4 D3 D2 D1 D0    hours   [0..23]
            //                I/O DATA 3   D7 D6 D5 D4 D3 D2 D1 D0    day     [1..31]
            //                I/O DATA 4   D7 D6 D5 D4 D3 D2 D1 D0    month   [1..12]
            //                I/O DATA 5   D7 D6 D5 D4 D3 D2 D1 D0    year    [0..99] (6th data byte)
            //
            // NOTE 1: Before the first byte read (seconds) call SYSFLAGS to reset the I/O byte counter to "seconds"
            // NOTE 2: If RTC is not found all read values wil be = 0
            // NOTE 3: Overread data (more then 6 bytes read) will be = 0

            if (foundRTC)
            {
               if (RTCbyteCnt == 0) readRTC(&seconds, &minutes, &hours, &day, &month, &year); // Read from RTC
               if (RTCbyteCnt < 6)
               // Send date/time (binary values) to Z80 bus
               {
                  switch (RTCbyteCnt)
                  {
                    case 0: ioData = seconds; break;
                    case 1: ioData = minutes; break;
                    case 2: ioData = hours; break;
                    case 3: ioData = day; break;
                    case 4: ioData = month; break;
                    case 5: ioData = year; break;
                  }
                  RTCbyteCnt++;
               }
            }
          break;
        }
        if (debugLev & debugLev2)
        {
          Serial.print("IOS: I/O READ operation requested"); 
          Serial.print(" - DATA: ");
          if (ioData < 0x10) Serial.print("0");
          Serial.print(ioData, HEX);
          Serial.print(" ");
          printBinaryByte(ioData);
          Serial.print(" ADDR: ");
          if (ioAddress < 0x10) Serial.print("0");
          Serial.print(ioAddress, HEX);
          Serial.print(" ");
          printBinaryByte(ioAddress);
          Serial.println();        
        }
        DDRA = 0xFF;                               // Configure Z80 data bus D0-D7 (PA0-PA7) as output
        PORTA = ioData;                            // Current output on data bus

        // Control bus sequence to exit from a wait state (M I/O read cycle)
        digitalWrite(BUSREQ_, LOW);                // Request for a DMA
        digitalWrite(WAIT_RES_, LOW);              // Now is safe reset WAIT FF (exiting from WAIT state)
        delayMicroseconds(2);                      // Wait 2us just to be sure that Z80 read the data and go HiZ
        DDRA = 0x00;                               // Configure Z80 data bus D0-D7 (PA0-PA7) as input with pull-up
        PORTA = 0xFF;
        digitalWrite(WAIT_RES_, HIGH);             // Now Z80 is in DMA (HiZ), so it's safe set WAIT_RES_ HIGH again
        digitalWrite(BUSREQ_, HIGH);               // Resume Z80 from DMA
      }
      else
      // INTERRUPT operation setting IORQ_ LOW, so nothing to do
      {
        if (debugLev & debugLev2) Serial.println("IOS: INT operation (nothing to do)");

        // Control bus sequence to exit from a wait state (M interrupt cycle)
        digitalWrite(BUSREQ_, LOW);                // Request for a DMA
        digitalWrite(WAIT_RES_, LOW);              // Reset WAIT FF exiting from WAIT state
        digitalWrite(WAIT_RES_, HIGH);             // Now Z80 is in DMA, so it's safe set WAIT_RES_ HIGH again
        digitalWrite(BUSREQ_, HIGH);               // Resume Z80 from DMA
      }
  }
}

// ------------------------------------------------------------------------------

void printBinaryByte(byte value)
{
  for (byte mask = 0x80; mask; mask >>= 1)
  {
    Serial.print((mask & value) ? '1' : '0');
  }
}

// ------------------------------------------------------------------------------

void serialEvent()
// Set INT_ to ACTIVE if there are received chars from serial to read and if the interrupt generation is enabled
{
  if ((Serial.available()) && Z80IntEnFlag) digitalWrite(INT_, LOW);
}

// ------------------------------------------------------------------------------

byte decToBcd(byte val)
// Convert a binary byte to a two digits BCD byte
{
  return( (val/10*16) + (val%10) );
}

// ------------------------------------------------------------------------------

byte bcdToDec(byte val)
// Convert binary coded decimal to normal decimal numbers
{
  return( (val/16*10) + (val%16) );
}

// ------------------------------------------------------------------------------

void readRTC(byte *second, byte *minute, byte *hour, byte *day, byte *month, byte *year)
// Read current date/time binary values from the DS3231 RTC
{
  Wire.beginTransmission(DS3231_RTC);
  Wire.write(DS3231_SECRG);                        // Set the DS3231 Seconds Register
  Wire.endTransmission();
  // Read from RTC and convert to binary
  Wire.requestFrom(DS3231_RTC, 7);
  *second = bcdToDec(Wire.read() & 0x7f);
  *minute = bcdToDec(Wire.read());
  *hour = bcdToDec(Wire.read() & 0x3f);
  Wire.read();                                     // Jump over the DoW
  *day = bcdToDec(Wire.read());
  *month = bcdToDec(Wire.read());
  *year = bcdToDec(Wire.read());
}

// ------------------------------------------------------------------------------

void writeRTC(byte second, byte minute, byte hour, byte day, byte month, byte year)
// Write given date/time binary values to the DS3231 RTC
{
  Wire.beginTransmission(DS3231_RTC);
  Wire.write(DS3231_SECRG);                        // Set the DS3231 Seconds Register
  Wire.write(decToBcd(seconds));
  Wire.write(decToBcd(minutes));
  Wire.write(decToBcd(hours));
  Wire.write(1);                                   // Day of week not used (always set to 1 = Sunday)
  Wire.write(decToBcd(day));
  Wire.write(decToBcd(month));
  Wire.write(decToBcd(year));
  Wire.endTransmission();
}

// ------------------------------------------------------------------------------

byte autoSetRTC()
// Check if the DS3231 RTC is present and set the date/time at compile date/time if 
// the RTC "Oscillator Stop Flag" is set (= date/time failure).
// Return value: 0 if RTC not present, 1 if found.
// NOTE: If the Virtual Disk Module is not present the RTC will be always disabled/not foud
{
  byte    OscStopFlag;

  Wire.beginTransmission(DS3231_RTC);
  if ((Wire.endTransmission() != 0) || (!vDisk)) return 0;       // RTC not found (or Virtual Disk Module not present)
  Serial.print("IOS: Found RTC DS3231 Generic Module (");
  printDateTime(1);
  Serial.println(")");
  
  // Read the "Oscillator Stop Flag"
  Wire.beginTransmission(DS3231_RTC);
  Wire.write(DS3231_STATRG);                       // Set the DS3231 Status Register
  Wire.endTransmission();
  Wire.requestFrom(DS3231_RTC, 1);
  OscStopFlag = Wire.read() & 0x80;                // Read the "Oscillator Stop Flag"

  if (OscStopFlag)
  // RTC oscillator stopped. RTC must be set at compile date/time
  {
    // Convert compile time strings to numeric values
    seconds = compTimeStr.substring(6,8).toInt();
    minutes = compTimeStr.substring(3,5).toInt();
    hours = compTimeStr.substring(0,2).toInt();
    day = compDateStr.substring(4,6).toInt();
    switch (compDateStr[0]) 
      {
        case 'J': month = compDateStr[1] == 'a' ? 1 : month = compDateStr[2] == 'n' ? 6 : 7; break;
        case 'F': month = 2; break;
        case 'A': month = compDateStr[2] == 'r' ? 4 : 8; break;
        case 'M': month = compDateStr[2] == 'r' ? 3 : 5; break;
        case 'S': month = 9; break;
        case 'O': month = 10; break;
        case 'N': month = 11; break;
        case 'D': month = 12; break;
      };
    year = compDateStr.substring(9,11).toInt();

    // Ask for RTC setting al compile date/time
    Serial.println("IOS: RTC clock failure!");
    Serial.print("\nDo you want set RTC at IOS compile time (");
    printDateTime(0);
    Serial.print(")? [Y/N] >");
    timeStamp = millis();
    do
    {
      blinkD0(&timeStamp);
      inChar = Serial.read();
    }
    while ((inChar != 'y') && (inChar != 'Y') && (inChar != 'n') &&(inChar != 'N'));
    Serial.println(inChar);
 
    // Set the RTC at the compile date/time and print a message
    if ((inChar == 'y') || (inChar == 'Y'))
    {
      writeRTC(seconds, minutes, hours, day, month, year);
      Serial.print("IOS: RTC set at compile time - Now: ");
      printDateTime(1);
      Serial.println();
    }

    // Reset the "Oscillator Stop Flag" 
    Wire.beginTransmission(DS3231_RTC);
    Wire.write(DS3231_STATRG);                          // Set the DS3231 Status Register
    Wire.write(0x08);                                   // Reset the "Oscillator Stop Flag" (32KHz output left enabled)
    Wire.endTransmission();
  }
  return 1;
}

// ------------------------------------------------------------------------------

void printDateTime(byte readSourceFlag)
// Print to serial the current date/time.
//
// Flag readSourceFlag [0..1] usage:
//    If readSourceFlag = 0 the RTC read is not done
//    If readSourceFlag = 1 the RTC read is done
{
  if (readSourceFlag) readRTC(&seconds, &minutes, &hours, &day,  &month,  &year);
  print2digit(day);
  Serial.print("/");
  print2digit(month);
  Serial.print("/");
  print2digit(year);
  Serial.print(" ");
  print2digit(hours);
  Serial.print(":");
  print2digit(minutes);
  Serial.print(":");
  print2digit(seconds);
}

// ------------------------------------------------------------------------------

void print2digit(byte data)
// Print a byte [0..99] using 2 digit with leading zeros if needed
{
  if (data < 10) Serial.print("0");
  Serial.print(data);
}

// ------------------------------------------------------------------------------

byte isLeapYear(byte yearXX)
// Check if the year 2000+XX (where XX is the argument yearXX [00..99]) is a leap year.
// Returns 1 if it is leap, 0 otherwise.
// This function works in the [2000..2099] years range. It should be enough...
{
  if (((2000 + yearXX) % 4) == 0) return 1;
  else return 0;
}

// ------------------------------------------------------------------------------

void ChangeRTC()
// Change manually the RTC Date/Time from keyboard
{
  byte    leapYear;   //  Set to 1 if the selected year is bissextile, 0 otherwise [0..1]

  // Read RTC
  readRTC(&seconds, &minutes, &hours, &day,  &month,  &year);

  // Change RTC date/time from keyboard
  tempByte = 0;
  Serial.println("\nIOS: RTC manual setting:");
  Serial.println("\nPress T/U to increment +10/+1 or CR to accept");
  do
  {
    do
    {
      Serial.print(" ");
      switch (tempByte)
      {
        case 0:
          Serial.print("Year -> ");
          print2digit(year);
        break;
        
        case 1:
          Serial.print("Month -> ");
          print2digit(month);
        break;

        case 2:
          Serial.print("             ");
          Serial.write(13);
          Serial.print(" Day -> ");
          print2digit(day);
        break;

        case 3:
          Serial.print("Hours -> ");
          print2digit(hours);
        break;

        case 4:
          Serial.print("Minutes -> ");
          print2digit(minutes);
        break;

        case 5:
          Serial.print("Seconds -> ");
          print2digit(seconds);
        break;
      }

      timeStamp = millis();
      do
      {
        blinkD0(&timeStamp);
        inChar = Serial.read();
      }
      while ((inChar != 'u') && (inChar != 'U') && (inChar != 't') && (inChar != 'T') && (inChar != 13));
      
      if ((inChar == 'u') || (inChar == 'U'))
      // Change units
        switch (tempByte)
        {
          case 0:
            year++;
            if (year > 99) year = 0;
          break;

          case 1:
            month++;
            if (month > 12) month = 1;
          break;

          case 2:
            day++;
            if (day > (daysOfMonth[month - 1] + isLeapYear(year))) day = 1;
          break;

          case 3:
            hours++;
            if (hours > 23) hours = 0;
          break;

          case 4:
            minutes++;
            if (minutes > 59) minutes = 0;
          break;

          case 5:
            seconds++;
            if (seconds > 59) seconds = 0;
          break;
        }
      if ((inChar == 't') || (inChar == 'T'))
      // Change tens
        switch (tempByte)
        {
          case 0:
            year = year + 10;
            if (year > 99) year = year - (year / 10) * 10; 
          break;

          case 1:
            if (month > 10) month = month - 10;
            else if (month < 3) month = month + 10;
          break;

          case 2:
            day = day + 10;
            if (day > (daysOfMonth[month - 1] + isLeapYear(year))) day = day - (day / 10) * 10;
            if (day == 0) day = 1;
          break;

          case 3:
            hours = hours + 10;
            if (hours > 23) hours = hours - (hours / 10 ) * 10;
          break;

          case 4:
            minutes = minutes + 10;
            if (minutes > 59) minutes = minutes - (minutes / 10 ) * 10;
          break;

          case 5:
            seconds = seconds + 10;
            if (seconds > 59) seconds = seconds - (seconds / 10 ) * 10;
          break;
        }
      Serial.write(13);
    }
    while (inChar != 13);
    tempByte++;
  }
  while (tempByte < 6);  

  // Write new date/time into the RTC
  writeRTC(seconds, minutes, hours, day, month, year);
  Serial.println(" ...done      ");
  Serial.print("IOS: RTC date/time updated (");
  printDateTime(1);
  Serial.println(")");
}

// ------------------------------------------------------------------------------

void blinkD0(unsigned long *timestamp)
// Blink led D0 using a timestamp
{
  if ((millis() - *timestamp) > 200)
  {
    digitalWrite(LED_D0,!digitalRead(LED_D0));
    *timestamp = millis();
  }
}
